engThiagoJunior/SDR/hardware/esquematico-completo.png

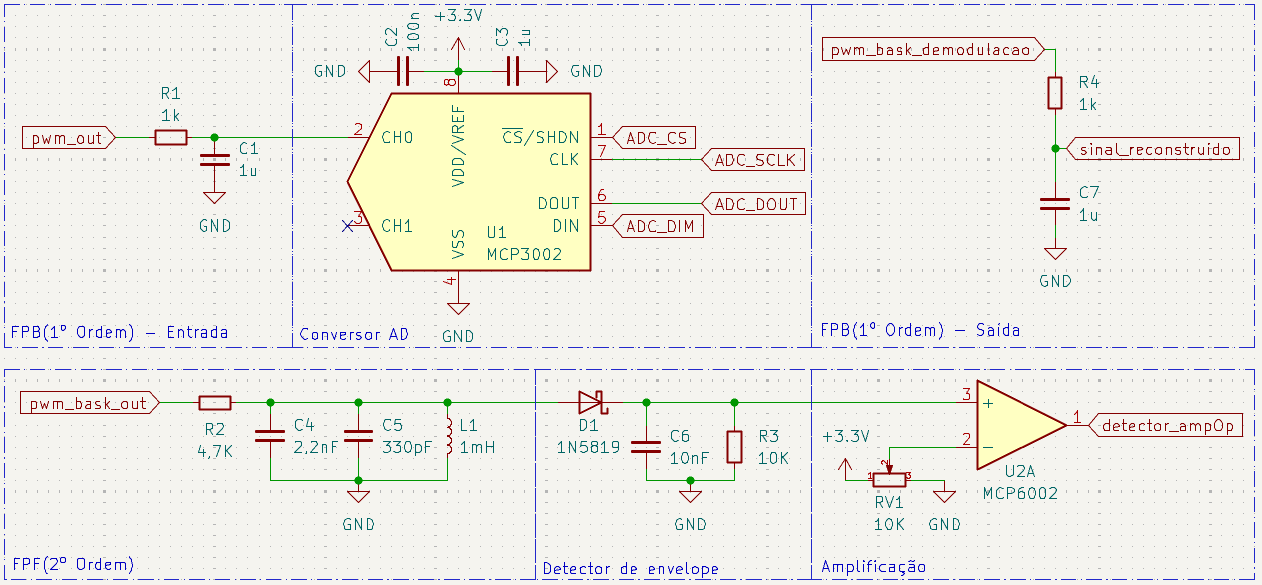
hardware/esquematico-completo.png
