engThiagoJunior/SDR/(commit log)

2026-07-01 Adicionando módulos Verilog do projeto de modulador configurável
2026-11-03 Organiza o projeto e adiciona README
    Agrupa o Verilog em rtl/ com nomes descritivos, remove a cópia idêntica
    de pwm_generator.v e documenta arquitetura, blocos e compilação.
    Claude-Session: https://claude.ai/code/session_01QbP9NK9TP2g65Wzc1wjJ5w
2026-11-03 Documenta o projeto completo com resultados
    Adiciona relatório final, figuras, esquemático, lista de componentes e
    projeto Quartus com caminhos atualizados. Move os scripts para scripts/
    e reescreve o README com requisitos, etapas, evidências e pinagem.
    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
2026-11-03 Adiciona seleção por chave e testes automatizados
    Seleciona BASK ou 4-ASK pela SW0, mantém o receptor ativo, corrige
    comentários e adiciona testbenches autoverificáveis em sim/.
    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
    [PWM_MCP.v, ask4_modulador.v, bask_demodulator.v, mcp3002_model.v, rom_sin_model.v, tb_adc_bask.v, tb_ask4.v]
2026-11-04 Update lista-de-componentes.md to remove specific values
    Removed the mention of specific component values from the text.
